rishitha1907/Obstacle_Avoidance/obstacle_avoider_full_assembly.step

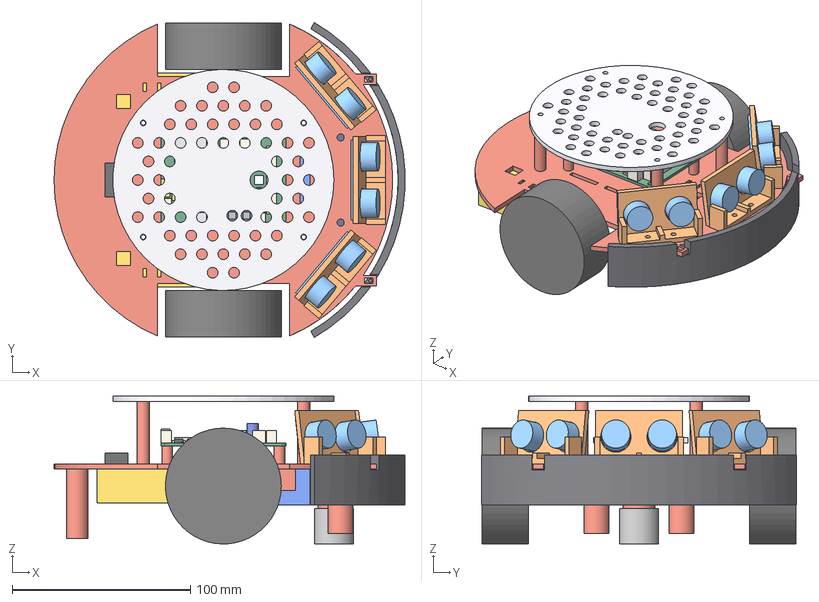
[picture p2: CAD file, 2026-10-28]
obstacle_avoider_full_assembly.step
196.9 x 176.7 x 83.0 mm
Chassis
Top_Deck
Front_Bumper
Sensor_Mount_Front
HC-SR04_Front
Sensor_Mount_Left
HC-SR04_Left
Sensor_Mount_Right
HC-SR04_Right
Bumper_Switch_1
Bumper_Switch_2
motor_L
wheel_L
motor_R
wheel_R
battery
caster_unit
switch_body
tcrt_0
tcrt_1
PCB_board
U1_ESP32-S3_module
U5_IMU
D3_Status_RGB_LED
U7_Level_shifter
SW2_BOOT___START_button
SW1_RESET_button
BZ1_Buzzer
U2_Motor_driver
C9_Motor_bulk_cap
U3_5_V_buck_regulator
L1_Buck_inductor
D5_Buck_catch_diode
U4_33_V_LDO
Q1_Reverse-polarity_FET
F1_Resettable_fuse
D1_TVS_diode
D2_USB_OR-ing_diode
LED1_Power_LED
U6_USB_ESD_protection
J1_USB-C_(programming)
J2_Battery_connector
J10_Power_switch_conn
J3_Ultrasonic_LEFT
J4_Ultrasonic_FRONT
J5_Ultrasonic_RIGHT
J8_Cliff_sensor_LEFT
J12_Bumper_switch_LEFT
J9_Cliff_sensor_RIGHT
J13_Bumper_switch_RIGHT
J6_Motor_LEFT_and_encoder
J7_Motor_RIGHT_and_encoder
J11_Qwiic_I2C_expansion
