rishitha1907/Obstacle_Avoidance/schematic.pdf

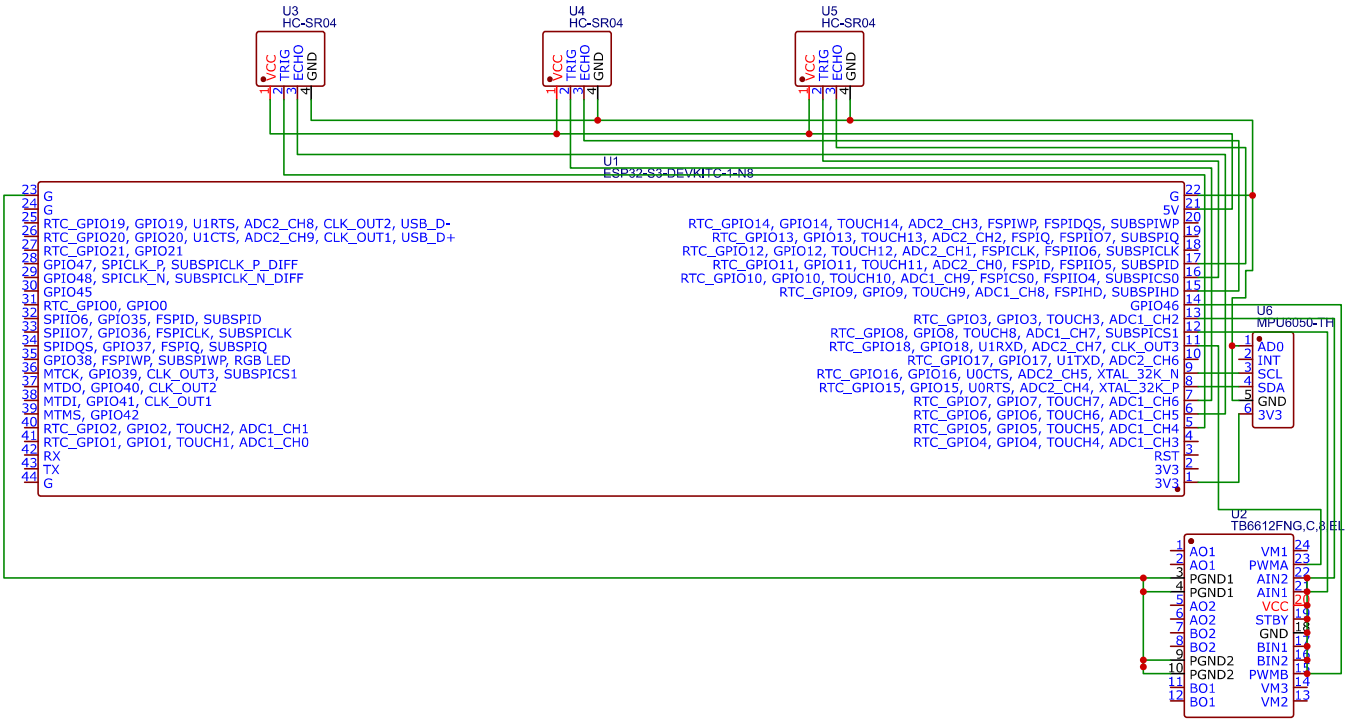
[picture p3: page 1]
